nukemberg/biometric-status-bracelet/docs/img/breath_fold_01.png

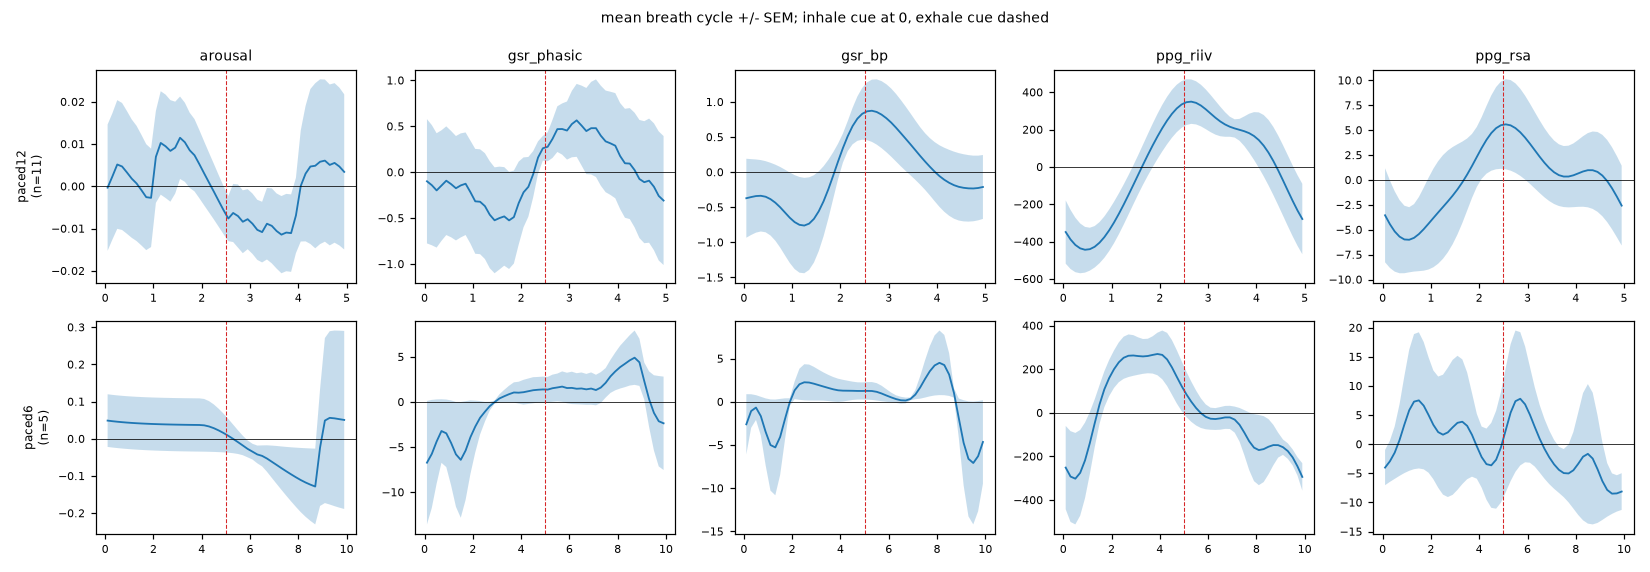
docs/img/breath_fold_01.png
