nukemberg/biometric-status-bracelet/docs/img/breath_fold_02.png

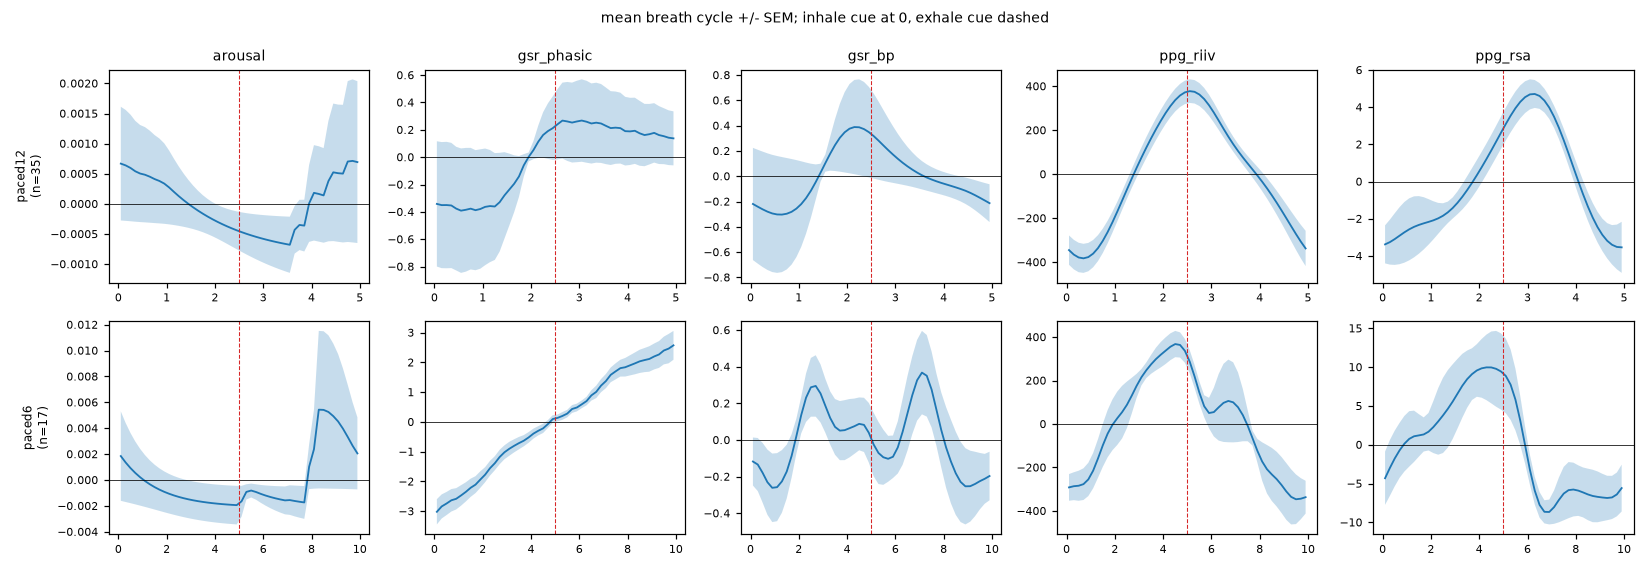
docs/img/breath_fold_02.png
