nukemberg/biometric-status-bracelet/tools/dsp_v2_sim.py

#!/usr/bin/env python3
"""
Offline reference implementation of the DSP v2 pipeline.

This is a deliberate mirror of the C++ in libraries/BraceletDSP: same sample rates,
same filter coefficients, same scalar arithmetic, same update order. It exists so the
firmware can be validated against recorded captures before it is flashed, and so
regressions are caught on the desktop.

Usage:
    uv run --with numpy,scipy tools/dsp_v2_sim.py capture.csv
    uv run --with numpy,scipy tools/dsp_v2_sim.py capture.csv --compare

Input format is the raw_streamer CSV: Timestamp_ms,RawIr,RawGSR,IrNew.

The two front ends no longer share a clock. GSR is sampled at 500 Hz and decimated
20:1; PPG arrives from the MAX30102's own FIFO at ~25 Hz, and IrNew marks the rows
where a new sample actually landed. PulseTracker.update() is called once per IrNew=1
row and RawIr is ignored entirely on the others -- it is 0 there, not a held value.

Captures in the old three-column Timestamp_ms,RawPulse,RawGSR format are from the
analog front end and are rejected by load() rather than reinterpreted. They are not
merely stale: the pulse column is a 12-bit ADC reading of a different sensor, and
every threshold derived from it (DESIGN.md section 2) belongs to that hardware.
"""

import argparse
import cmath
import math
import sys

# ---------------------------------------------------------------------------
# Configuration (keep in sync with firmware/dsp_v2/dsp_v2.ino)
# ---------------------------------------------------------------------------
FS_RAW = 500.0  # GSR only; the MAX30102 clocks its own FIFO
DECIM = 20  # 500 Hz -> 25 Hz. The 40 ms boxcar nulls 25/50/75 Hz (mains).
FS = FS_RAW / DECIM  # 25 Hz -- the rate BOTH trackers run at

# Pulse chain
HP_HZ = 0.5  # baseline tracker
LP_HZ = 4.0  # two cascaded poles, kills the 10.2 Hz tremor artifact
ENERGY_TAU = 2.0

# Resonator bank
BPM_MIN = 40.0
BPM_MAX = 190.0
N_BINS = 48
BANK_TAU = 10.0

# acPower (perfusion's numerator) used to share BANK_TAU with the resonator bank; split
# 2026-09-02 because the two want opposite things -- the bank needs a long time constant
# for frequency resolution, perfusion just wants to settle quickly after a contact
# disturbance. See dsp.h for the full rationale. Mirrors dsp.h's PERF_TAU.
PERF_TAU = 5.0
RENORM_INTERVAL = 256  # rotator renormalisation period, in samples

# BPM output shaping.
#
# Confidence on this hardware is weak and only mildly discriminative (measured
# separation between good and bad windows is ~1.3x), so it is used as a *weight* on
# how fast the BPM may move rather than as a hard accept/reject gate. Low confidence
# therefore parks the reading on its last good value instead of letting it jump,
# which is exactly the behaviour the LEDs want.
SLEW_BPM_PER_S = 8.0
CONF_REF = 0.18  # peak/total power ratio treated as "fully trusted"
CONF_GATE = 0.06  # below this the bank is treated as noise; BPM is frozen

# Peak search tie-break: harmonics/subharmonics of the true pulse land outside
# normal resting-to-exertion HR and can outscore the fundamental on a noisy
# capture. Bins in [NORMAL_BPM_LO, NORMAL_BPM_HI] compete on raw power; bins
# outside are attenuated so they only win when clearly stronger. Full BPM_MIN..MAX
# range stays searchable -- this only biases the tie-break. Mirrors dsp.h.
NORMAL_BPM_LO = 50.0
NORMAL_BPM_HI = 140.0
OUT_OF_RANGE_WEIGHT = 0.5


def bpm_search_weight(bpm):
    return 1.0 if NORMAL_BPM_LO <= bpm <= NORMAL_BPM_HI else OUT_OF_RANGE_WEIGHT

# GSR chain
TONIC_TAU = 45.0
PHASIC_TAU = 0.7
SCR_ATTACK_TAU = 0.15
SCR_RELEASE_TAU = 3.0
# counts/s. A ceiling on apparent phasic rise rate, not a rejector -- see the long
# comment in dsp.h. 60 was inert on every capture we have (max observed slope 54.7,
# in the artifact-heavy breath_paced_01.csv), while real SCRs peak at 2.5-9.7. 15
# keeps ~1.5x margin over the strongest physiological slope and cuts artifact
# saturation 4.28 % -> 3.10 %. Severe artifacts on the older analog front end reached
# 570, so the ceiling does bind on the bad cases it exists for. Must match dsp.h.
SLOPE_CLAMP = 15.0
#
# FLOOR_ATTACK/RELEASE_TAU replace the old RANGE_TAU mean-tracker (see -9ny, -l96): a
# plain EMA of drive settles arousal near 1/RANGE_GAIN at ANY steady drive level,
# resting or not, because the normalizer chases whatever drive currently is -- right
# for an LED display that must stay reactive, wrong for an absolute measure. This
# instead tracks the recent QUIET-baseline floor: fast down when drive is below it
# (chases the true noise floor quickly), slow up when drive is above it (so a real,
# sustained SCR can't drag its own baseline up and erode itself within the
# observation window). A peak-hold envelope was tried and rejected for the same
# reason a floor-*hold* would be: one contact artifact pins it and crushes
# everything after -- this is a floor-*track*, not a hold.
#
# Calibrated 2026-09-03 against a live capture: FLOOR_ATTACK_TAU=2s /
# FLOOR_RELEASE_TAU=15s let a ~15s clench-induced SCR erode its own floor and decay
# back to near-zero in under 10s -- physiologically too fast (real SCR recovery runs
# 10-20s+). 180s keeps the floor stable across any single real event while still
# able to re-learn a genuinely new resting baseline over a multi-minute session.
FLOOR_ATTACK_TAU = 2.0
FLOOR_RELEASE_TAU = 180.0
# Tuned as a PAIR with FLOOR_MIN -- see the long comment in dsp.h. FLOOR_MIN is both
# the dead-zone threshold and, via RANGE_GAIN * floor, the output scale; -0b6 was
# FLOOR_MIN=3.0 setting the threshold above real SCR drive, so 4 of 7 cued responses
# reported exactly zero. The denominator that guards against dither is preserved
# (3.0 * 2.5 = 7.5 before, 1.2 * 6.0 = 7.2 now) while the threshold drops 2.5x.
RANGE_GAIN = 6.0  # drive must reach 6x the quiet-baseline floor to peg the bar
# counts/s. Not an operating point -- a guard against the denominator collapsing.
# Keeps a dead/disconnected sensor from being amplified, and -- since one ADC count
# of movement between samples is already 25 counts/s at DSP_HZ -- keeps quantisation
# dither from pegging the bar. 1.2 sits below the quiet drive this hardware actually
# shows (p50 0.80 - 3.01 across sessions). Must match FLOOR_MIN in dsp.h. Fitting
# the anti-alias RC (-jg6) would let this go lower still.
FLOOR_MIN = 1.2
OUT_ATTACK_TAU = 0.10
OUT_RELEASE_TAU = 1.50


def ema_alpha(tau_s, fs=FS):
    """EMA coefficient for a given time constant."""
    return 1.0 - math.exp(-1.0 / (tau_s * fs))


def onepole_alpha(fc_hz, fs=FS):
    """EMA coefficient for a given -3 dB corner frequency."""
    return 1.0 - math.exp(-2.0 * math.pi * fc_hz / fs)


class PulseTracker:
    """Sliding-DFT resonator bank: yields BPM, confidence and beat phase together.

    Per-beat threshold detection fails on this signal (measured SNR is below 1 for
    most of bio2.log). A bank of complex one-pole resonators integrates over many
    cycles instead, so a missed or noisy beat degrades the estimate rather than
    stalling it -- and the winning bin's argument gives a continuous beat phase for
    free, which is what actually drives the LEDs.
    """

    def __init__(self):
        self.a_hp = onepole_alpha(HP_HZ)
        self.a_lp = onepole_alpha(LP_HZ)
        self.a_energy = ema_alpha(ENERGY_TAU)
        self.a_bank = ema_alpha(BANK_TAU)
        self.a_perf = ema_alpha(PERF_TAU)

        self.baseline = None
        self.lp1 = 0.0
        self.lp2 = 0.0
        self.energy = 0.0
        self.ac_power = 0.0

        # Bin centres, linear in BPM.
        self.bpms = [
            BPM_MIN + (BPM_MAX - BPM_MIN) * k / (N_BINS - 1) for k in range(N_BINS)
        ]
        # Per-bin rotation step e^(-j*w_k); advanced recursively so the sample loop
        # never calls sin/cos.
        self.step = [cmath.exp(-1j * 2.0 * math.pi * (b / 60.0) / FS) for b in self.bpms]
        self.rot = [complex(1.0, 0.0)] * N_BINS
        self.res = [complex(0.0, 0.0)] * N_BINS
        self.n = 0

        self.bpm = 78.0
        self.confidence = 0.0
        self.phase = 0.0
        self.filtered = 0.0

    def update(self, x):
        """Feed one 25 Hz sample. Returns the filtered (band-limited) value."""
        if self.baseline is None:
            self.baseline = x
            self.lp1 = 0.0
            self.lp2 = 0.0

        self.baseline += self.a_hp * (x - self.baseline)
        ac = x - self.baseline
        self.lp1 += self.a_lp * (ac - self.lp1)
        self.lp2 += self.a_lp * (self.lp1 - self.lp2)
        y = self.lp2
        self.filtered = y

        self.energy += self.a_energy * (y * y - self.energy)
        self.ac_power += self.a_perf * (y * y - self.ac_power)

        for k in range(N_BINS):
            r = self.rot[k] * self.step[k]
            self.rot[k] = r
            self.res[k] += self.a_bank * (y * r - self.res[k])

        self.n += 1
        if self.n % RENORM_INTERVAL == 0:
            # Recursive rotation drifts off the unit circle; pull it back.
            for k in range(N_BINS):
                m = abs(self.rot[k])
                if m > 0.0:
                    self.rot[k] /= m

        return y

    def perfusion(self):
        """Cardiac AC as a percentage of DC level. Mirrors dsp.h's perfusion()."""
        if self.baseline is None or self.baseline < 1.0:
            return 0.0
        return 100.0 * 2.83 * math.sqrt(self.ac_power) / self.baseline

    def update_filtered(self, y):
        """Feed a sample that has ALREADY been through the baseline/lowpass chain --
        the pulse_filtered field of a BLE Signals packet, computed on-device by this
        same PulseTracker. Used to re-run the resonator bank offline against a live
        BLE capture, which has no raw 500 Hz signal to decimate and filter (the
        device only streams the already-decimated, already-filtered 25 Hz value).
        Bypasses the baseline/lowpass stage in update() above; everything from the
        resonator bank onward is identical, so estimate() behaves the same either way.
        """
        self.filtered = y
        self.energy += self.a_energy * (y * y - self.energy)
        self.ac_power += self.a_perf * (y * y - self.ac_power)
        for k in range(N_BINS):
            r = self.rot[k] * self.step[k]
            self.rot[k] = r
            self.res[k] += self.a_bank * (y * r - self.res[k])
        self.n += 1
        if self.n % RENORM_INTERVAL == 0:
            for k in range(N_BINS):
                m = abs(self.rot[k])
                if m > 0.0:
                    self.rot[k] /= m

    def estimate(self, dt_s):
        """Called at render rate, not per sample. Updates bpm/confidence/phase.

        Search excludes bins 0 and N_BINS-1 (the BPM_MIN/BPM_MAX edges), mirroring
        dsp.h's PulseTracker::estimate(). On-skin captures 2026-09-02 repeatedly pinned
        to bin 0 (40 BPM) at low confidence with no real signal there; an edge bin also
        has no neighbor on one side, so the parabolic interpolation below was already
        unsafe for it.
        """
        best = 1
        best_score = -1.0
        total_p = 0.0
        for k in range(N_BINS):
            p = self.res[k].real ** 2 + self.res[k].imag ** 2
            total_p += p
            score = p * bpm_search_weight(self.bpms[k])
            if 0 < k < N_BINS - 1 and score > best_score:
                best_score = score
                best = k
        best_p = self.res[best].real ** 2 + self.res[best].imag ** 2

        # Parabolic interpolation on the power peak for sub-bin resolution.
        raw_bpm = self.bpms[best]
        lo = self.res[best - 1].real ** 2 + self.res[best - 1].imag ** 2
        hi = self.res[best + 1].real ** 2 + self.res[best + 1].imag ** 2
        denom = lo - 2.0 * best_p + hi
        if abs(denom) > 1e-12:
            shift = 0.5 * (lo - hi) / denom
            shift = max(-1.0, min(1.0, shift))
            raw_bpm += shift * (self.bpms[1] - self.bpms[0])

        # Peak share of total bank power. Scale-free and bounded: flat noise across
        # the bank gives 1/N_BINS, a dominant rhythm gives much more.
        self.confidence = best_p / (total_p + 1e-12)
        # Instantaneous beat phase. arg(R) alone is only the *offset* of the beat
        # relative to the demodulation reference -- for a signal sitting on the bin
        # frequency R is a near-static phasor, so it does not advance once per beat.
        # Multiplying the rotator back in (R * conj(rot)) restores the running phase.
        beat = self.res[best] * self.rot[best].conjugate()
        self.phase = math.atan2(beat.imag, beat.real)

        if self.confidence >= CONF_GATE:
            weight = min(1.0, self.confidence / CONF_REF)
            limit = SLEW_BPM_PER_S * weight * dt_s
            delta = max(-limit, min(limit, raw_bpm - self.bpm))
            self.bpm += delta
        return self.bpm, self.confidence, self.phase


class GsrTracker:
    """Two-timescale skin-conductance decomposition with auto-ranging.

    Arousal is driven by the *rate of rise* of the phasic component, not by its
    offset from a baseline, so the slow tonic drift (1412 -> 1281 counts over
    bio2.log) cannot zero the output the way the previous fixed-scale delta did.
    """

    def __init__(self):
        self.a_tonic = ema_alpha(TONIC_TAU)
        self.a_phasic = ema_alpha(PHASIC_TAU)
        self.a_attack = ema_alpha(SCR_ATTACK_TAU)
        self.a_release = ema_alpha(SCR_RELEASE_TAU)
        self.a_floor_down = ema_alpha(FLOOR_ATTACK_TAU)
        self.a_floor_up = ema_alpha(FLOOR_RELEASE_TAU)
        self.a_out_attack = ema_alpha(OUT_ATTACK_TAU)
        self.a_out_release = ema_alpha(OUT_RELEASE_TAU)

        self.tonic = None
        self.smooth = 0.0
        self.prev = 0.0
        self.drive = 0.0
        self.floor = FLOOR_MIN
        self.arousal = 0.0

    def reset(self, x):
        """Long-press recalibration: re-anchor tonic and the floor envelope."""
        self.tonic = x
        self.smooth = x
        # `prev` holds the previous PHASIC value, not the previous raw sample, and
        # phasic is zero by construction immediately after a reset (smooth == tonic).
        # Seeding it with x made the next update see slope = x * FS -- 35000 counts/s
        # on a 1400-count signal -- which clamps to SLOPE_CLAMP and drives arousal to
        # full scale for several seconds after every recalibration. dsp.h has always
        # had this right (`prevPhasic = 0.0f`); this was a transcription error here.
        #
        # It went unnoticed because the captures it was checked against start with a
        # real contact transient that saturates arousal on BOTH sides, so the two
        # agreed at the 1.0 ceiling. samples/synthetic.csv starts quiet and separates
        # them: 0.107 (C++) against 1.000 (here).
        self.prev = 0.0
        self.drive = 0.0
        self.floor = FLOOR_MIN
        self.arousal = 0.0

    def update(self, x):
        if self.tonic is None:
            self.reset(x)

        self.smooth += self.a_phasic * (x - self.smooth)
        self.tonic += self.a_tonic * (self.smooth - self.tonic)
        phasic = self.smooth - self.tonic

        # Grove GSR output *falls* as skin conductance rises, so a falling value is
        # the arousal direction. Half-wave rectify: only rises count. The slope is
        # taken on the phasic component, not on the smoothed signal -- the raw signal
        # drifts downward at ~0.9 counts/s over bio2.log, which would otherwise read
        # as permanent arousal.
        slope = (self.prev - phasic) * FS  # counts/s of rising conductance
        self.prev = phasic
        if slope < 0.0:
            slope = 0.0
        elif slope > SLOPE_CLAMP:
            slope = SLOPE_CLAMP

        a = self.a_attack if slope > self.drive else self.a_release
        self.drive += a * (slope - self.drive)

        # Normalize against the recent quiet-baseline floor, not the recent mean --
        # see FLOOR_ATTACK/RELEASE_TAU comment above.
        a = self.a_floor_down if self.drive < self.floor else self.a_floor_up
        self.floor += a * (self.drive - self.floor)
        if self.floor < FLOOR_MIN:
            self.floor = FLOOR_MIN

        target = min(1.0, max(0.0, (self.drive - self.floor) / (RANGE_GAIN * self.floor)))
        a = self.a_out_attack if target > self.arousal else self.a_out_release
        self.arousal += a * (target - self.arousal)
        return self.arousal, self.tonic, phasic


# ---------------------------------------------------------------------------
# Legacy algorithm, transcribed from main_armband.ino for side-by-side comparison
#
# Only the GSR engine survives here. The legacy threshold-and-refractory pulse
# detector was removed along with the analog PPG sensor it was tuned for: its
# hardcoded operating point (baseline 1712, window 1670-1750, x10 gain) is a 12-bit
# ADC reading of the XY1911-074, and running it against 18-bit MAX30102 IR counts
# would emit beat times that mean nothing. The comparison it existed to make is
# settled and recorded in DESIGN.md section 2.2; re-running it against a different
# sensor would not re-answer it.
#
# The GSR path is unchanged -- same sensor, same ADC, same rate -- so this one is
# still a valid before/after.
# ---------------------------------------------------------------------------
def legacy_gsr(gsr):
    sm = 1350.0
    base = 1350.0
    ex = 0.0
    out = []
    for v in gsr:
        sm = 0.1 * v + 0.9 * sm
        if sm > base:
            base = base * 0.999 + sm * 0.001
        else:
            base = base * 0.9999 + sm * 0.0001
        delta = max(0.0, base - sm)
        e = min(1.0, delta / 120.0)
        ex = ex * 0.7 + e * 0.3
        out.append(ex)
    return out


# ---------------------------------------------------------------------------


def load(path):
    """Read a raw_streamer capture. Returns (t_ms, ir, gsr, ir_new).

    Rejects the pre-MAX30102 three-column format loudly. Silently treating its
    RawPulse column as an IR channel would produce a full set of plausible numbers
    from the wrong sensor, which is the one outcome this harness exists to prevent.
    """
    t, ir, g, new = [], [], [], []
    saw_row = False
    with open(path) as fh:
        for line in fh:
            parts = line.strip().split(",")
            if len(parts) == 3:
                saw_row = True
                continue
            if len(parts) != 4:
                continue
            try:
                ts = float(parts[0])
                v_ir = float(parts[1])
                v_g = float(parts[2])
                v_new = int(parts[3])
            except ValueError:
                continue  # header or comment
            t.append(ts)
            ir.append(v_ir)
            g.append(v_g)
            new.append(v_new)

    if not t and saw_row:
        sys.exit(
            f"{path}: this is a 3-column analog capture "
            f"(Timestamp_ms,RawPulse,RawGSR). The PPG front end is now a MAX30102 "
            f"and captures must carry Timestamp_ms,RawIr,RawGSR,IrNew. Recapture "
            f"with firmware/raw_streamer; see DESIGN.md section 5."
        )
    return t, ir, g, new


def run(path, report_hz=1.0, verbose=True):
    t, ir, g, ir_new = load(path)
    if not t:
        sys.exit(f"{path}: no usable samples")

    pulse = PulseTracker()
    gsr = GsrTracker()

    acc_g = 0.0
    acc_n = 0
    last_report = t[0]
    last_est = t[0]
    rows = []

    for i in range(len(t)):
        # PPG is event-driven off the sensor FIFO, so it advances on its own rows and
        # not on the decimation boundary. The firmware drains the FIFO at that
        # boundary instead, which groups the calls differently but leaves the SEQUENCE
        # of PulseTracker.update() calls identical -- and the tracker is advanced per
        # sample, not per wall-clock instant, so the two stay bit-identical.
        if ir_new[i]:
            pulse.update(ir[i])

        acc_g += g[i]
        acc_n += 1
        if acc_n < DECIM:
            continue
        xg = acc_g / DECIM
        acc_g = 0.0
        acc_n = 0

        arousal, tonic, phasic = gsr.update(xg)

        # Render-rate work: the firmware does this at 60 FPS; 25 Hz here is the
        # fastest the sim can, and the results are rate-insensitive.
        dt = (t[i] - last_est) / 1000.0
        last_est = t[i]
        bpm, conf, phase = pulse.estimate(dt)

        if t[i] - last_report >= 1000.0 / report_hz:
            last_report = t[i]
            rows.append((t[i] / 1000.0, bpm, conf, phase, arousal, tonic))

    if verbose:
        dur = (t[-1] - t[0]) / 1000.0
        n_ir = sum(ir_new)
        # The effective PPG rate is a property of the sensor's oscillator, not of this
        # script, and every resonator bin frequency assumes it is FS. Print it so a
        # capture that would scale every BPM is visible before the numbers are trusted.
        print(f"# {path}  ({dur:.1f} s, {len(t)} raw rows, {n_ir} PPG samples "
              f"= {n_ir / dur if dur else 0:.2f} Hz, expected {FS:.2f})")
        print("time_s,bpm,confidence,phase_rad,arousal,tonic")
        for r in rows:
            print(
                f"{r[0]:.1f},{r[1]:.1f},{r[2]:.2f},{r[3]:.2f},{r[4]:.3f},{r[5]:.1f}"
            )
    return t, ir, g, rows


def summarise(path, rows, t, ir, g, settle_s=20.0):
    import statistics

    t0 = t[0] / 1000.0
    warm = [r for r in rows if r[0] - t0 >= settle_s]
    bpms = [r[1] for r in warm]
    confs = [r[2] for r in warm]
    arous = [r[4] for r in warm]

    # Longest stretch with confidence below the gate.
    worst_gap = 0.0
    gap_start = None
    for r in warm:
        if r[2] < CONF_GATE:
            if gap_start is None:
                gap_start = r[0]
            worst_gap = max(worst_gap, r[0] - gap_start)
        else:
            gap_start = None

    dur = (t[-1] - t[0]) / 1000.0
    lgsr = legacy_gsr(g)

    # IR DC level, from the rows that carry a real sample. This is the first thing to
    # check on a new capture: too low and the LED current is starved or the sensor is
    # off the skin; near 2^18 and the ADC is clipping the cardiac AC away at the top
    # of its range. Both look like "no pulse" downstream. See DESIGN.md section 4.2.
    ir_live = [v for v in ir if v > 0]

    print(f"\n=== {path} ===")
    print(f"duration                 {dur:.1f} s")
    print("--- ppg front end ---")
    if ir_live:
        print(f"IR DC median             {statistics.median(ir_live):.0f}"
              f"  (min {min(ir_live):.0f} max {max(ir_live):.0f}, full scale 262143)")
        print(f"IR sample rate           {len(ir_live) / dur:.2f} Hz"
              f"  (dsp assumes {FS:.2f})")
    else:
        print("IR                       no samples -- MAX30102 absent during capture")
    print("--- pulse ---")
    print(f"dsp_v2  BPM median       {statistics.median(bpms):.1f}")
    print(f"dsp_v2  BPM std          {statistics.pstdev(bpms):.1f}")
    print(f"dsp_v2  BPM min/max      {min(bpms):.1f} / {max(bpms):.1f}")
    print(f"dsp_v2  confidence med   {statistics.median(confs):.2f}")
    print(f"dsp_v2  longest low-conf {worst_gap:.1f} s")
    print("--- gsr ---")
    print(f"legacy  arousal mean     {statistics.mean(lgsr):.3f}"
          f"  max {max(lgsr):.3f}")
    print(f"legacy  time at zero     {100.0 * sum(1 for v in lgsr if v < 0.02) / len(lgsr):.1f} %")
    print(f"dsp_v2  arousal mean     {statistics.mean(arous):.3f}"
          f"  max {max(arous):.3f}")
    print(f"dsp_v2  time at zero     {100.0 * sum(1 for v in arous if v < 0.02) / len(arous):.1f} %")
    print(f"dsp_v2  time saturated   {100.0 * sum(1 for v in arous if v > 0.95) / len(arous):.1f} %")


def run_ble(path, report_hz=1.0):
    """Re-analyse a `tools/blectl.py stream` capture.

    That capture has no raw 500 Hz signal -- the device only streams pulse_filtered,
    the value AFTER its own baseline/lowpass chain (tools/blectl.py stream --csv
    header: timestamp_ms,pulse_filtered,gsr_phasic,pulse_raw,gsr_raw). So this feeds
    pulse_filtered straight into the resonator bank via update_filtered(), skipping
    the front-end filtering stage that already happened on-device, rather than
    re-decimating and re-filtering raw ADC counts the way `run()` above does for a
    raw_streamer capture.

    This exists mainly to look at the same harmonic-capture behaviour documented in
    DESIGN.md 2.3 from a live BLE capture instead of an offline one -- the same
    question tools/blectl.py spectrum answers on-device in real time, from a
    different angle.
    """
    pulse = PulseTracker()
    rows = []
    last_report = None
    with open(path) as fh:
        header = fh.readline().strip().split(",")
        try:
            ts_i = header.index("timestamp_ms")
            pf_i = header.index("pulse_filtered")
        except ValueError:
            sys.exit(f"{path}: not a blectl stream CSV (header: {header})")
        for line in fh:
            parts = line.strip().split(",")
            if len(parts) <= max(ts_i, pf_i):
                continue
            ts_ms = float(parts[ts_i])
            y = float(parts[pf_i])
            pulse.update_filtered(y)
            bpm, conf, phase = pulse.estimate(1.0 / FS)
            if last_report is None or ts_ms - last_report >= 1000.0 / report_hz:
                last_report = ts_ms
                rows.append((ts_ms / 1000.0, bpm, conf, phase))
    return rows


def main():
    ap = argparse.ArgumentParser(description=__doc__)
    ap.add_argument("logs", nargs="+", help="raw_streamer CSV capture(s)")
    ap.add_argument("--compare", action="store_true",
                    help="print the summary table instead of the per-second trace")
    ap.add_argument("--rate", type=float, default=1.0,
                    help="trace output rate in Hz (default 1)")
    ap.add_argument("--from-ble", action="store_true",
                    help="input is a `blectl.py stream --csv` capture, not a raw "
                         "500 Hz raw_streamer capture -- see run_ble()")
    args = ap.parse_args()

    if args.from_ble:
        for path in args.logs:
            rows = run_ble(path, report_hz=args.rate)
            print(f"# {path} (BLE stream re-analysis, {len(rows)} rows)")
            print("time_s,bpm,confidence,phase_rad")
            for t, bpm, conf, phase in rows:
                print(f"{t:.1f},{bpm:.1f},{conf:.2f},{phase:.2f}")
        return

    for path in args.logs:
        t, ir, g, rows = run(path, report_hz=args.rate, verbose=not args.compare)
        if args.compare:
            summarise(path, rows, t, ir, g)


if __name__ == "__main__":
    main()
