nukemberg/biometric-status-bracelet/(commit log)

2026-07-31 Initial commit: biometric bracelet firmware, DSP tooling and design
    Wearable forearm panel reading heart rate, skin conductance and temperature
    onto a 21-LED WS2812B matrix.
    The pulse engine is a sliding-DFT resonator bank rather than threshold beat
    detection. On this hardware the cardiac signal sits below the noise floor for
    poor contact (SNR < 1), where threshold-and-refractory detectors measured
    113.8 and 187.4 BPM against a true ~88 BPM. The bank yields rate, confidence
    and beat phase together, and degrades smoothly instead of stalling. Measured
    62.2 BPM median against a 64 BPM manual count on samples/bio4.csv.
    GSR arousal is driven by the rate of rise of the phasic component and
    auto-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
    [bio3.csv, bio4.csv]
2026-07-31 Design: BLE service, web app and CLI
    Adds the connectivity design to docs/DESIGN.md: a single custom GATT service
    (vitals, 25 Hz signals, resonator spectrum, control, config, info) over NimBLE,
    an Android Web Bluetooth page served from GitHub Pages, and a bleak-based CLI.
    Custom service rather than the standard Heart Rate Service because 0x180D
    cannot express confidence or wear state, and this sensor's BPM should not be
    published as though generic fitness apps can trust it.
    The spectrum characteristic exists to watch harmonic capture live — the one
    tracking defect offline analysis could only infer.
    Records the core-0 contention risk between the NimBLE controller task and the
    500 Hz DSP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
2026-07-31 Extract DSP into a shared BraceletDSP library
    main_armband.ino was 741 lines and dsp_v2.ino carried a near-duplicate copy of
    the same trackers, free to drift apart. Both now consume one library.
    libraries/BraceletDSP/src/dsp.h depends only on <math.h> and <stdint.h>. That
    constraint is the point: tools/dsp_v2_parity.sh can compile the exact trackers
    the firmware runs and prove them equal to the Python reference, which is how
    every bug in this pipeline has been found. The harness no longer needs any
    Arduino stubbing at all, so tools/hoststub is deleted.
    WearDetect no longer calls pulse.clearBank() directly; it reports the release
    through a justReleased flag and the caller acts. Reaching int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
    [dsp_v2.ino, dsp_v2_parity.cpp, main_armband.ino]
2026-07-31 Add BraceletProtocol: BLE wire format with golden-byte tests
    Three implementations will decode these packets — firmware, CLI and web app —
    and a layout disagreement between them decodes to plausible wrong numbers
    rather than raising an error. Two guards against that.
    Every packet leads with BLE_PROTOCOL_VERSION, so a mismatch is rejected
    instead of guessed at. Fields are written at explicit little-endian offsets
    rather than by memcpy of a packed struct, because struct layout is not the
    same across Xtensa firmware, a host test and a browser.
    tools/ble_packet_test.cpp asserts the layout against hardcoded byte vectors.
    Round-trip tests alone are not enough: they pass happily when two fiel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
    [ble_packet_test.cpp]
2026-07-31 Record the v1/v2 hardware roadmap
    v1 is the analog path and everything in DESIGN.md section 2 is calibrated
    against it. v2 (MAX30102, optionally ADS1115) attacks the SNR wall that no
    amount of DSP has moved, but it invalidates that calibration: the perfusion
    index, trust and confidence thresholds, bank tau and harmonic measurements are
    all properties of the analog path, and the sample captures stop being valid
    regression cases. Recording that cost explicitly so v2 is a deliberate choice
    rather than a surprise.
    An IMU is independent and can land first — it changes no front end and
    invalidates nothing.
2026-07-31 Measure DSP loop scheduling jitter
    The 20-sample boxcar nulls 50 Hz only because its window is exactly 40 ms,
    which assumes the sampling loop really runs every 2 ms. A NimBLE controller
    task will share core 0 with it, so establish the baseline before the radio
    exists rather than arguing about it afterwards.
    JitterMonitor lives in BraceletDSP and takes micros() from the caller, so it
    stays free of Arduino types and host-testable. Verified against a perfect
    cadence, an injected stall, and micros() wraparound.
    Baseline, no BLE: mean 2000.0 us, min 1812, max 2187, zero overruns across
    5003 samples per 10 s window. The boxcar window is intact.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
    [main_armband.ino]
2026-07-31 Add tools/capture.py and a way to observe settled state
    Opening the serial port asserts DTR/RTS and reboots the ESP32, so every short
    capture showed a cold-booting device. That invalidated more analysis than it
    should have: the GSR tonic EMA needs 45 s and the resonator bank 10 s, and no
    capture so far had run long enough for either.
    Suppressing the reset in software does not work on this CP210x adapter --
    clearing DTR/RTS before open and disabling HUPCL were both tried and the board
    rebooted regardless. Holding the port open does work: one reset at start, then
    continuous logging. Verified over 90 s with a single boot marker and four
    consecutive settled jitter windows.
    The script also flag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
    [capture.py]
2026-07-31 Add NimBLE GATT service with Info and Vitals notify
    Custom service over NimBLE (283 KB, against ~700 KB for Bluedroid), so the
    default partition table still fits: 454 -> 776 KB, 59% used.
    ble_service only knows how to advertise and how to pack a snapshot. It never
    reaches into PulseTracker or GsrTracker -- the caller hands it a finished
    BleVitals. That keeps the dependency arrow pointing away from BraceletDSP,
    which is what lets the DSP stay host-testable.
    Vitals are snapshotted under the portMUX lock and packed and sent outside it:
    NimBLE can block, and holding a critical section across that would stall the
    DSP task on core 0, which is exactly the interference -a75 is meant to measure.
    E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
    [ble_service.cpp, ble_service.h, main_armband.ino]
2026-07-31 Measure whether BLE jitter actually hurts the 50 Hz notch
    It does not. BLE advertising widens the sampling period spread from +/-190 us
    to +/-850 us, but the 20-sample boxcar still rejects mains by 35 dB, leaving
    0.24 counts of a 14-count interferer against SCR features of 10-40 counts.
    Even a full period of jitter costs under 0.6 counts.
    The notch degrades gracefully because vTaskDelayUntil holds an absolute
    deadline: timing error does not accumulate, so the window length stays exact
    and only its uniformity suffers. Sample counts confirm none are dropped.
    So no core rebalancing, and no hardware-timer sampling. Recording the levers in
    DESIGN.md in case that changes under a live streaming c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
    [jitter_notch.py]
2026-07-31 Add blectl: read the bracelet over BLE without a USB tether
    Removes the two constraints that have shaped every measurement so far —
    connecting over USB reboots the board, so no capture ever saw settled state,
    and it required the wearer beside the laptop.
    The wire format lives in tools/bracelet_protocol.py, separate from the CLI so
    the stream, spectrum and config subcommands can share it. It decodes the same
    golden fixtures that tools/ble_packet_test.cpp asserts in C++, exposed as
    `blectl.py selftest`, so a drift between the firmware and Python decoders is
    caught rather than silently producing plausible wrong numbers. Version and
    length mismatches raise instead of decoding.
    Device lookup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
    [blectl.py, bracelet_protocol.py]
2026-07-31 Add control characteristic and the signals and spectrum streams
    Control validates every command before dispatch and takes handlers from the
    caller, so ble_service still knows nothing about display modes or trackers.
    Bank resets are deferred to the DSP task rather than applied inline: clearing
    the bank while update() is midway through the resonator loop would corrupt it.
    Streams reset on disconnect, since leaving them on would have the DSP task
    packing notifications nobody receives.
    The signals stream took two attempts to get right. The first consumed from the
    ring buffer and ignored notify()'s return, so every time NimBLE's TX buffers
    filled a batch vanished -- 15.6 Hz against an expected 2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
    [ble_service.cpp, ble_service.h, blectl.py, main_armband.ino]
2026-07-31 Add the Web Bluetooth dashboard
    Single self-contained page, no build step and no CDN, since it has to be served
    from GitHub Pages and Web Bluetooth refuses an insecure origin.
    Its thesis is that the readings need context. This device has been measured
    reporting a confident 91 BPM with nothing attached, so trust is not a badge
    beside a number that looks fine: when the bracelet says the pulse is not
    believable the whole readout drains to grey and the BPM is replaced by "--".
    Verified against the exact packet the bench device emits, which renders as
    "Not on a wrist. Readings are noise."
    The signature element is a live mirror of the 21 LEDs in their real 3x7
    layout, so you can hold your wrist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
2026-07-31 blectl stream/spectrum to CSV, and a real ring-buffer bug found testing it
    blectl spectrum --csv writes a 48-column CSV (time, peak bpm, peak bin, then
    the 48 bin powers), satisfying that half of -t7k directly.
    The stream side is not literally raw_streamer-compatible: the Signals
    characteristic carries the already-decimated, already-filtered 25 Hz value
    (pulse_filtered), not raw 500 Hz ADC counts, so feeding it through
    dsp_v2_sim.py's normal decimate-and-filter path would apply the front end
    twice at the wrong rate. Instead PulseTracker gains update_filtered(), which
    starts from the resonator bank rather than from raw counts, and
    `dsp_v2_sim.py --from-ble` re-runs the bank against a stream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
    [blectl.py, dsp_v2_sim.py, main_armband.ino]
2026-07-31 Add BraceletConfig, NVS persistence, and wire CMD_RESET_CONFIG
    BraceletConfig collects the runtime tunables -- LED hue anchors, wear
    thresholds, confidence gate/reference, BPM slew -- into one struct in dsp.h,
    deliberately excluding anything that sizes a fixed array (N_BINS, BPM_MIN/MAX)
    since those are static_assert'd against the BLE spectrum packet and would need
    dynamic allocation to become runtime-variable. The existing #defines stay the
    single source of the numeric defaults, so this is additive: nothing that
    already worked changes behaviour by existing. Confirmed by parity and packet
    tests passing unchanged.
    PulseTracker and WearDetect gained applyConfig() rather than reading the cfg
    s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
    [config_store.cpp, config_store.h, main_armband.ino]
2026-07-31 Staged brownout-safe boot + document the -av5 brownout observation
    Code-side mitigation for -av5 (left open: root cause still wants a real
    current measurement, filed as -xbr.2):
    - setup() now stages the two highest-inrush peripherals (RMT/LED driver
    and BLE radio) apart, with short settle delays and [boot] log markers
    around each so a future capture can time any recurrence to a stage.
    - LEDs are held off across radio init (already true; now explicit).
    Analysis recorded in DESIGN.md sec 6: the 'full-brightness startup sweep'
    the original note speculated about is not in the code; the observed E BOD
    logged right after RMT init (before BLE) and self-recovered after 2-3
    cycles, which is cha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
    [main_armband.ino]
2026-08-01 Defer LED driver init until after radio to fix brownout loop
    On-device testing with the [boot] log markers showed every E BOD fires
    right after '[boot] starting radio', never after the LED driver.
    Disconnecting the LED strip eliminates the brownout, confirming the
    strip's input capacitance loads the rail enough to tip the radio's
    inrush over the brownout threshold.
    Fix: reorder setup() to bring up the radio FIRST (with the LED data
    line still floating/high-Z), then init the RMT driver and FastLED
    once the radio is stable and advertising. Boot sequence is now:
    DSP/BME/init -> DSP task -> radio -> LED driver -> done.
    Also add a Justfile for common workflows (build/upload/monitor/config).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
    [main_armband.ino]
2026-08-01 Persist brightness in NVS via BraceletConfig
    Brightness previously lived only in RAM (`bio.brightness`), so it reset to 60
    on every reboot. Adding `brightness` to `BraceletConfig` (default 60.0),
    `FIELDS` (bounds 0–255), `BleConfigParam` (`CFG_BRIGHTNESS = 0x0B`), and saving
    on `onSetBrightness()` makes brightness persist across reboots and update
    correctly on reset-to-defaults.
    Updated protocol parity (Python selftest, JS webapp tuning group).
    All automated tests pass.
    [bracelet_protocol.py, config_store.cpp, main_armband.ino]
2026-08-01 Fix webapp reconnect/disconnect click handler restoration
    When connected, `$("connect").onclick` was reassigned to disconnect the
    GATT server. However, upon disconnection (`gattserverdisconnected`), the
    handler was left pointing at the disconnected closure rather than being
    reset to `connect`, preventing the button from working on subsequent
    attempts. Restored `$("connect").onclick = connect;` in the disconnect
    listener.
2026-08-01 Recalibrate GSR wear window and arousal auto-range from on-wrist data
    Three findings from a wearing session, all traceable to constants derived
    from logged captures rather than from a wrist.
    Wear window. GSR_WORN_MAX was 3000, but the unworn bracelet reads ~2400 on
    the current electrodes, not the 3507-4095 the logged captures showed. An
    empty bracelet was therefore declared worn. Now 2100, which splits the two
    populations (worn measures 1000-1500). Bench-confirmed on hardware via the
    runtime config characteristic before being made the compiled default. This
    is a re-measurement, not a fix: an unworn sensor is a floating input and the
    unworn cluster moves between sessions, which is the point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
    [dsp_v2_sim.py]
2026-08-17 Replace the analog PPG sensor with a MAX30102 on the I2C bus
    The wall every DSP effort hit was SNR below 1 on the analog pulse sensor
    (DESIGN.md 2.1), and no algorithm recovers a signal beneath its noise floor.
    The MAX30102 brings its own LED driver, 18-bit ADC and ambient subtraction.
    It shares SDA/SCL with the BME280 -- 0x57 against 0x76/0x77, no collision.
    This is the PPG half of -kp5; ADS1115 for GSR is deliberately still open,
    because GSR was not the failing channel and swapping both front ends at once
    would have left no working reference for either.
    Sample path. Configured for 100 Hz internal sampling with 4x on-chip
    averaging, so the FIFO delivers exactly DSP_HZ = 25 and PulseTracker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
    [synthetic.csv]
2026-08-17 Claude permissions
    Allow the build, flash, capture and validation commands used while bringing
    up the MAX30102, plus the Playwright browser tools used to verify the web app
    layout without a bracelet attached.
2026-08-21 Move WS2812 to GPIO6, fix MAX30102 INT clearing, add boot self-test and BLE error log
    GPIO4 measured damaged during bring-up; strip now wires to GPIO6 on the S3 build.
    Max30102::read() never read INT_STATUS_1, so PPG_RDY latched low on the first
    sample and never released -- confirmed by a raw GPIO10 sampler (0 transitions
    over 10s while the FIFO was draining fine). Now cleared per sample, verified
    via a new [PPG] int edge-rate counter that tracks the existing FIFO rate.
    Also adds a boot-time LED self-test (all-blue flash, then per-segment
    GSR/pulse/temp status) and a 20-entry BLE-notified error log
    (BLE_CHR_LOG + CMD_DUMP_LOG) surfaced in the web app as a collapsible panel.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
    [ble_service.cpp, ble_service.h, led_test.ino, main_armband.ino]
2026-08-22 Reverse GSR VU-meter fill direction to match spiral LED wiring
    Strip is glued in a spiral (seg1 -> seg3 middle turn -> seg2), and segment 2's
    data-chain order runs opposite its visual span. The VU-meter filled from
    ledIndex 7 up; it now fills from 13 down so it lights in the correct physical
    direction. Segments 1 (symmetric) and 3 (already correct) are unaffected.
    [main_armband.ino]
2026-08-22 Refactor LED segment layout into named consts instead of hardcoded indices
    SEG_A/SEG_B/SEG_C (base + direction) plus segLed() replace the scattered
    7+i/13-i/14+i literals. Positional names, not feature names -- which
    physiological reading each slot shows depends on the caller
    (renderBiometricPanel vs bootSelfTest map them differently). No behavior
    change, same compiled size.
    [main_armband.ino]
2026-08-22 Fold docs/AGENTS.md into DESIGN.md, remove the collision with bd's root AGENTS.md
    docs/AGENTS.md was the original hardware/product spec, superseded by DESIGN.md
    for everything technical. Preserved the two bits DESIGN.md didn't already
    cover: the fabric-sleeve/velcro mounting detail, and the multi-device festival
    sync idea (unscoped, just noted for later).
2026-08-22 Update DESIGN.md for how the build actually ended up
    Pin map: WS2812 is GPIO6 not GPIO4 (GPIO4 measured damaged during bring-up);
    external button is wired in firmware (GPIO5) but not physically populated on
    this build. MAX30102 INT section rewritten -- it's now wired and read (edge
    counter cross-checks the FIFO rate), and documents the real bug found getting
    there: read() never cleared PPG_RDY (needs INT_STATUS_1, not FIFO_DATA), plus
    the second GND pin on the INT-side header that also needs wiring. Documents
    the LED spiral mount (SEG_A/B/C + segLed()), the new Log GATT characteristic
    and CMD_DUMP_LOG, and the boot self-test.
2026-08-22 blectl: add log subcommand, CLI now has parity with the web app's Log panel
    The BLE_CHR_LOG characteristic and CMD_DUMP_LOG command landed in an earlier
    firmware session (52ae7d7) with web app support but no CLI support. `blectl.py
    log` subscribes, sends CMD_DUMP_LOG to replay the device's buffered history
    (must happen after subscribing or the replay notifications go out before the
    central has enabled them), then tails new entries live. Log is plain ASCII by
    design (not the versioned binary protocol -- a debug aid, not the scientific
    data path), so there's nothing to decode.
2026-08-22 Add web app manifest for installable standalone mode on Android Chrome
    manifest.json + icon.svg (three dots in the pulse/arousal/thermal palette,
    matching the device's own three segments), both plain static files -- no
    build step, consistent with the rest of this app.
    Android Chrome only: Web Bluetooth has no iOS Safari implementation, so an
    installed home-screen icon on iPhone would open a dashboard that can never
    connect, install or not. Documented in the HTML comment. No service worker
    on purpose -- caching the app shell risks serving stale decode logic against
    a newer firmware protocol version, the exact silent-wrong-number failure mode
    ble_protocol.h exists to prevent.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
2026-08-22 Rename web app title to BioMonitor
    Title, wordmark, manifest name/short_name, apple-mobile-web-app-title. Left
    the BLE device-name fallback strings ("Bracelet") alone -- that's the
    hardware's advertised name, a separate thing from the app's own title.
2026-08-22 Use onboard S3 NeoPixel (GPIO48) as a BLE connection/error status LED
    Second FastLED controller alongside the main strip -- one show() flushes
    both. Dim breathing blue while advertising/not connected, dim solid green
    when a client is connected, flashes red 400ms on every new BleService::log()
    entry via a new lastLogMs() getter. Runs every frame in loop() independent
    of worn state/display mode, so it stays live in Standby too. Guarded by
    #ifdef PIN_STATUS_LED, S3-only (WROOM-32 dev board has no onboard NeoPixel).
    Not yet verified on hardware -- device unavailable this session.
    [ble_service.cpp, ble_service.h, main_armband.ino]
2026-08-22 Add biofeedback mode: GSR-adaptive breathing, LED strip + webapp visual (-ssl)
    mode=3 fits the existing 2-bit VF_MODE_MASK, no protocol version bump.
    CMD_SET_MODE validation bumped from arg>2 to arg>3.
    Firmware: renderBreathing() replaces the usual 3-segment split with one
    full-panel breathing mark (hue 96->240 by arousal, same range as the GSR
    VU-meter). advanceBreathPhase() is a self-contained phase accumulator --
    half-cycle duration adapts 3s (aroused) to 6s (calm), own millis()-delta dt,
    no signature change needed elsewhere.
    Webapp: 4th "Breathe" mode button (reuses existing generic data-mode
    wiring) plus a dedicated section with a circle that scales/recolors each
    animation frame from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
    [ble_service.cpp, main_armband.ino]
2026-08-23 Fix BME280 reporting a constant fabricated temperature; log I2C at boot
    Two changes to the same subsystem, found together.
    BME280 was never converting
    ---------------------------
    Bench measurement (firmware/bme_test) showed the fitted part does not
    retain normal mode: a write of mode=normal to ctrl_meas is ACKed and
    reads back correctly, then clears itself to sleep within 1 ms -- the same
    at 100 kHz, so not signal integrity. Chip id (0x60) and calibration
    (T1=28604 T2=27121 T3=50) are plausible and forced mode converts
    correctly, so only the persistent configuration is lost. Adafruit's
    begin() leaves the chip in normal mode, so the raw registers kept their
    0x80000 power-on value and readTem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
    [main_armband.ino]
2026-08-23 Add BME280 bench test: reads raw registers under the library
    Chases the impossible-temperature report (185 C) by reading beneath
    Adafruit_BME280, which has no error return -- readTemperature() always
    yields a finite float computed from whatever the raw registers held, so
    the failure is invisible from the library API alone.
    Logs chip id, status, the raw ADC word, this sketch's own datasheet
    compensation from coefficients read directly off the chip, and the
    library's value, so the three candidate faults separate cleanly:
    transient I2C corruption of the raw burst, a chip that is not converting,
    and calibration coefficients corrupted at begin(). The MAX30102 is
    initialised and drained at 25 Hz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
    [bme_test.ino]
2026-08-24 Add I2C bus-recovery clock-out for the SDA-stuck-low boot fault (-iee)
    Standard I2C bus recovery (I2C spec "Bus Clear"): pulse SCL up to 9 times
    while SDA is read-only, then issue a STOP condition, run only when
    i2cIdleProbe() sees the specific "SDA low, SCL fine" signature. Also adds
    a one-shot retry of bme.begin()/ppg.begin() after a 100ms settle delay if
    both are still missing post-recovery (tryInitSensors(), refactored out of
    setup() so it's callable twice).
    Confirmed on hardware: the clock-out does electrically release SDA (idle
    probe reads it HIGH again afterward) on every fault reproduction. But the
    100ms-later retry still finds both sensors missing on the same boot --
    suggesting thi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
    [main_armband.ino]
2026-08-24 Add boot reset-reason logging, move I2C init after radio+LED bring-up (-iee)
    esp_reset_reason() logged as the first line of setup(), to check whether a
    faulted boot correlates with the hardware brownout detector.
    Moved I2C init (idle probe, Wire.begin, scan, sensor begin) from before the
    BLE radio and LED driver bring-up to after both, testing whether the
    SDA-stuck-low fault was from the same inrush -av5 already stages around.
    Result (logged in -iee): it wasn't. The fault reproduces at the same rate
    in the same signature regardless of when in boot I2C is probed, and the
    reset reason on a faulted boot was UNKNOWN, not BROWNOUT. This overturns
    the depressed-rail-at-inrush hypothesis from the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
    [main_armband.ino]
2026-08-24 Revert I2C init to before radio/LED bring-up; log I2C error-code breakdown
    The -iee timing experiment (previous commit) moved I2C init to after the
    radio+LED bring-up on the theory that the SDA-stuck-low fault was a
    depressed rail from the same inrush -av5 already stages around. That
    didn't move the fault rate, and the actual root cause turned out to be a
    broken SDA solder joint -- unrelated to init order. Reverting to the
    original order (I2C before radio/LED) since the reorder served no purpose
    once that was known.
    i2cScan() now tallies Wire.endTransmission() error codes across the full
    scan and logs a breakdown (data-too-long / data-NACK / other / timeout)
    whenever anything other than the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
    [main_armband.ino]
2026-09-02 Add BLE enter-bootloader command so the board can be flashed without buttons
    Once the board is installed in the sleeve rig, the BOOT and RESET buttons are not
    reachable. CMD_ENTER_BOOTLOADER (0x08) reboots it into the ESP32-S3 ROM USB download
    mode instead: the firmware sets RTC_CNTL_FORCE_DOWNLOAD_BOOT and restarts, and that
    flag survives only the reset it triggers, so the device enumerates as a bootloader on
    the native USB port and the next ordinary power cycle boots this firmware again.
    One-shot on purpose -- losing button access must not also mean a board can get
    stranded in download mode.
    It is the only control command that ends the session rather than changing something a
    user can cha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
    [ble_service.cpp, ble_service.h, blectl.py, bracelet_protocol.py, main_armband.ino]
2026-09-02 Stop the render loop stalling on USB CDC writes with no host draining the port
    The firmware could sit with a frozen LED strip and no vitals while still advertising
    and answering GATT reads, which made it look alive. loop() was blocked inside
    Serial.print: on the S3's native USB CDC, USBCDC::write spins on
    tud_cdc_n_write_available() for up to tx_timeout_ms -- 250 ms by default, per call --
    whenever the host has the port open but is not reading it.
    That state is easy to reach and gives no outward sign. Closing a serial monitor that
    had cleared HUPCL leaves DTR asserted, so tud_cdc_n_connected() stays true and the
    device goes on believing a host is listening while nothing drains the buffer. N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
    [main_armband.ino]
2026-09-02 Tune MAX30102 LED current, filter 40 BPM edge artifact, gate wear on PPG IR not GSR
    On-skin calibration (-yl2): 10mA LED current saturated IR DC to 157k-159k
    against the 262143 full scale, near the ADC ceiling and clipping the cardiac
    AC. Halved to 5mA (0x19); on-skin IR DC now settles ~70-85k, centered in the
    20k-150k target from DESIGN.md 4.2.
    The resonator peak search was pinning to bin 0 (40 BPM, the BPM_MIN edge) at
    low confidence with no real signal there. Edge bins also have no neighbor on
    one side, so the parabolic interpolation was already unsafe for them. Search
    now excludes bins 0 and N_BINS-1 in both dsp.h and its Python mirror
    (tools/dsp_v2_sim.py), keeping DSP parity intact.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
2026-09-02 Fix raw_streamer S3 pinout; capture first MAX30102 wrist samples, find harmonic lock
    raw_streamer.ino had MCU_ESP32_S3 commented out, so it compiled with the old
    WROOM-32 pinout (GPIO34/21/22) on S3 hardware. Both GSR and IR read all-zero
    for the entire capture with no error -- the sensor init and ADC reads just
    silently returned nothing on the wrong pins. Uncommented the define.
    Added the first two on-skin MAX30102 captures, filling the samples/ gap
    DESIGN.md 5 has flagged since the sensor swap:
    - wrist_max30102_80bpm.log: main_armband's own serial output, worn, ground
    truth ~80 BPM by manual radial count. Not the raw_streamer format the
    parity harness wants (kept as validation eviden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
    [raw_wrist_73bpm.csv]
2026-09-02 Investigate raw_wrist_73bpm.csv harmonic lock: motion artifact, not a DSP bug
    Tried two spectral fixes against the 2x runaway (subharmonic-power guard,
    sustained-monotonic-slew freeze) -- neither held; by mid-capture the 2x
    bin's own power genuinely exceeded the true-rate bin's, so no per-tick
    spectral heuristic can reject it without also risking real fast-HR
    transitions. A deliberately still capture under identical hardware
    (raw_wrist_65bpm_still.csv, ground truth 65 BPM) tracked cleanly with no
    runaway, confirming the lock is motion outcompeting cardiac signal in raw
    power -- the earlier capture had talking/typing happening during it. Full
    writeup on -9r7. No DSP code changed; this needs t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
    [raw_wrist_65bpm_still.csv]
2026-09-02 Complete PI_TRUST_MIN capture procedure; finding inverts DESIGN.md 3's ordering
    Ran the full unworn/loose/good procedure from DESIGN.md 4.2 step 3, properly
    settled this time -- PerfIdx's acPower is a 10s EMA, so a contact change
    (donning, tightening) takes 30-60s of *undisturbed* contact to decay out, not
    30-60s from when the strap went on. Several earlier attempts were invalidated
    by adjustments restarting the decay; documented that requirement in step 3.
    Result: good contact (180s, BPM cleanly tracked 68.9-81.4, IR rock-steady at
    69.5k) settles to PerfIdx 0.04-0.06%, *below* both loose (p90 0.56%) and
    unworn (p90 0.56%, statistically indistinguishable from loose). This inverts
    the assump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
2026-09-02 Split perfusion's time constant from the resonator bank's
    acPower (perfusion's numerator) shared BANK_TAU=10s with the resonator bank,
    but the two want opposite things: the bank needs a long time constant for
    frequency resolution (resolution ~1/(2*pi*tau); shortening it blurs
    neighboring bins together, exactly wrong when separating a fundamental from
    a harmonic -- see -9r7), while perfusion just wants to settle quickly after
    a contact disturbance so field calibration doesn't need 30-60s of stillness
    per capture, as today's session repeatedly hit.
    New PERF_TAU=5s drives acPower independently via a separate EMA coefficient
    (aPerf in dsp.h, a_perf in the Python mirror). Verified via a standalo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
    [dsp_v2_sim.py]
2026-09-03 Add unworn-to-worn transition capture; rule out phase coherence for trust gating
    One continuous 120s raw_streamer recording spanning unworn then worn, to test
    phase coherence as a PI_TRUST_MIN replacement without cross-capture confounds.
    Result on -9r7: unworn locks onto a stable false 155.5 BPM reading (confidence
    ~0.5, PerfIdx ~1.1-1.2%, sustained ~30s) with phase just as coherent as the
    genuine worn pulse -- whatever the tracker locks onto unworn is itself a stable
    ~2.58 Hz periodic signal, not incoherent noise, so phase coherence can't tell
    them apart. Candidate ruled out.
    But that false lock happened at IR DC 1650-2350, well below
    PPG_IR_WORN_MIN=5000 -- the shipped -6y4 fix already re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
    [raw_transition_unworn_to_worn.csv]
2026-09-03 Add tempOffsetC BLE-writable config tunable
    Wires a one-point calibration offset for the BME280 through the full
    tunable pipeline: BraceletConfig field, CFG_TEMP_OFFSET_C wire id,
    config_store FIELDS/NVS, applied at the read site in main_armband.ino,
    and the CLI/webapp CONFIG_PARAMS mirrors. Golden fixtures updated and
    verified against live hardware (get/set/reset round-trip, out-of-range
    rejected, offset visibly shifts the live reading).
    Also fixes brightness being absent from webapp's CONFIG_PARAMS id map,
    which meant its slider sent an undefined paramId.
    The actual reference-thermometer calibration is physical measurement
    work, filed separately as -5ia.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
    [ble_packet_test.cpp, bracelet_protocol.py, config_store.cpp, main_armband.ino]
2026-09-03 Phase-lock the webapp breathing circle to the device's LED blob
    Both sides ran the same GSR-adaptive half-cycle formula independently,
    so they beat at the same tempo but drifted out of phase from whatever
    moment each side started counting from -- confirmed as a real, visible
    complaint watching mode 3 live, not just a documented theoretical drift.
    Adds breathPhase (radians) to the vitals wire packet, using the byte
    that was previously reserved padding, so no length or version bump is
    needed. The device is now the phase authority: firmware sends its live
    breathPhase every packet, and the webapp snaps to it on arrival while
    still interpolating locally between packets for smooth animation.
    Ver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
    [ble_packet_test.cpp, bracelet_protocol.py, main_armband.ino]
2026-09-04 Rework GSR arousal normalizer: track a quiet-baseline floor, not a mean
    The old auto-range normalized `drive` against its own recent MEAN (30s
    EMA): target = drive / (RANGE_GAIN * meanOfDrive). At any steady drive
    level, resting or not, that settles arousal near 1/RANGE_GAIN by
    construction -- it can only see change relative to recent activity,
    never absolute arousal. Confirmed live: resting bounced continuously
    between 0.2-0.5, so a deliberate GSR event barely stood out against
    the noise floor. This was a known, documented tradeoff ("right for an
    LED display, wrong for a clinical measure") -- now deliberately
    reversed per direction to make the underlying measurement accurate,
    with any LED v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
    [dsp_v2_sim.py]
2026-09-04 Add disclosure chevron to Tuning/Device log summaries
    The <details> markers were hidden with no replacement, so the collapsible
    sections had no visual affordance.
    Claude-Session: https://claude.ai/code/session_01L9cCUVAA1AshPmnH5xFf4h
2026-09-04 Bias PPG peak search toward normal HR range on multi-candidate ties
    Harmonics/subharmonics of the true pulse can outscore the fundamental
    on noisy captures. Weight bank bins outside 50-140 BPM by 0.5x before
    picking the peak, so an out-of-range candidate must be clearly
    stronger to win. Full 40-190 search range unchanged; confidence and
    parabolic interpolation still use unweighted power. Ported to
    dsp_v2_sim.py for parity; test-parity confirms bit-identical output.
    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
2026-09-04 Establish breath-detection ground truth; RIIV wins, GSR arousal has a dead zone
    Bead -lc9 left an open question -- derive breath from the GSR phasic path or
    from the PPG? -- that no existing capture could answer, because none had a
    known breath cadence to score against. Two new tools and three captures
    settle it by measurement.
    tools/paced_capture.py paces the wearer and records in one process, writing
    its cue timings into the same CSV as `# MARK` rows anchored on the device
    clock. Ground truth and data therefore share a time base, and a paced capture
    is still a valid ordinary capture (consumers that split on ',' skip the mark
    rows). Stage kinds: paced (a metronome), sigh (isolated deep bre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
    [breath_paced_01.csv, breath_paced_02.csv, breath_sigh_01.csv]
2026-09-04 Fix GSR arousal dead zone: FLOOR_MIN was set above real SCR drive
    FLOOR_MIN does two jobs at once in
    target = (drive - floor) / (RANGE_GAIN * floor)
    It is the dead-zone threshold -- drive below the floor reports exactly zero --
    and, through the denominator, the output scale. The -l96 tuning raised it to
    3.0 to fix the scale, correctly per its dither argument, but that also lifted
    the threshold above the drive a genuine SCR produces.
    Measured on samples/breath_sigh_01.csv (seven deep breaths cued 60 s apart,
    each provoking an SCR): real responses produce drive of 1.45-8.01 counts/s
    against a threshold of 3.0, so four of the seven were reported as 0.000. The
    phasic component they derive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
    [dsp_v2_sim.py, gsr_scr_test.py]
2026-09-04 Lower SLOPE_CLAMP to 15; it was inert at 60 and never rejected anything
    The comment said SLOPE_CLAMP "rejects contact/motion steps". It does neither
    thing: it is a ceiling, not a rejector -- a capped step is still fed to the
    same drive envelope as a real response -- and at 60 it was inert, because no
    sample in any of the three breath captures ever reached it. The largest
    contact artifact we have, in breath_paced_01.csv, peaks at slope 54.7 and
    passed through completely untouched.
    Real SCRs peak at 2.5-9.7 counts/s across the seven cued sighs in
    breath_sigh_01.csv, so 60 sat 6x above anything physiological.
    15 keeps ~1.5x margin over the strongest real slope observed and cuts artifact
    satur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
2026-09-04 Make GSR arousal display curve BLE-tunable, not baked-in
    renderBreathing hue, firmware VU-meter, and the webapp's arousal
    VU-meter/breath-circle color were reading lifeless now that arousal is a
    genuine near-0-at-rest measurement. Add a presentation-only gamma+floor
    lift, applied only at those cosmetic render points -- the wire value,
    breath pacer timing, and numeric readout stay on the raw measurement.
    Wired as BraceletConfig.arousalDisplayGamma/Floor (new CFG_AROUSAL_GAMMA/
    FLOOR params, config_store schema bumped to v3) instead of #defines, so it
    can be tuned live from the webapp config panel while watching the device
    rather than by guess-and-reflash.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
